YHF-1404/dc_adj/readme/png/S10519-10523960.png

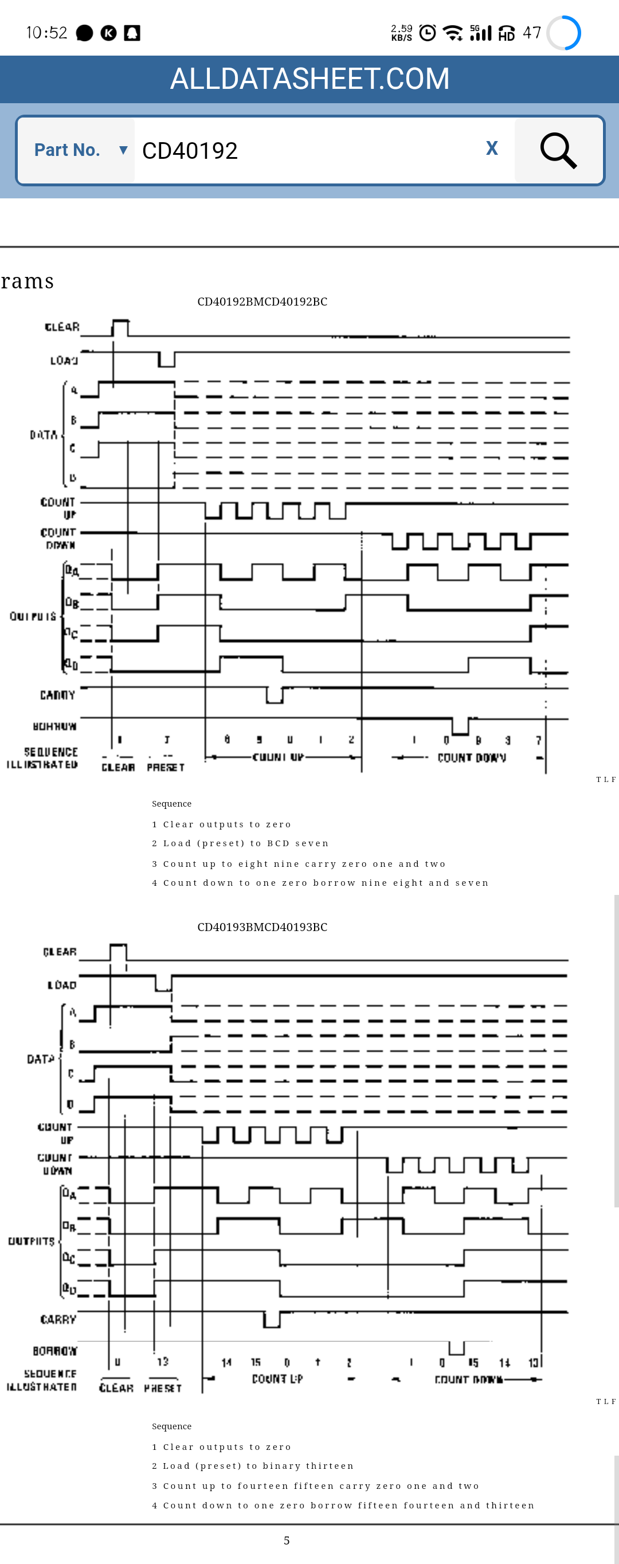
readme/png/S10519-10523960.png
