YHF-1404/dc_adj/readme/Schematic_dc_adj_2021-05-20.pdf

## 电源输出部分

## 输出电压测试端子

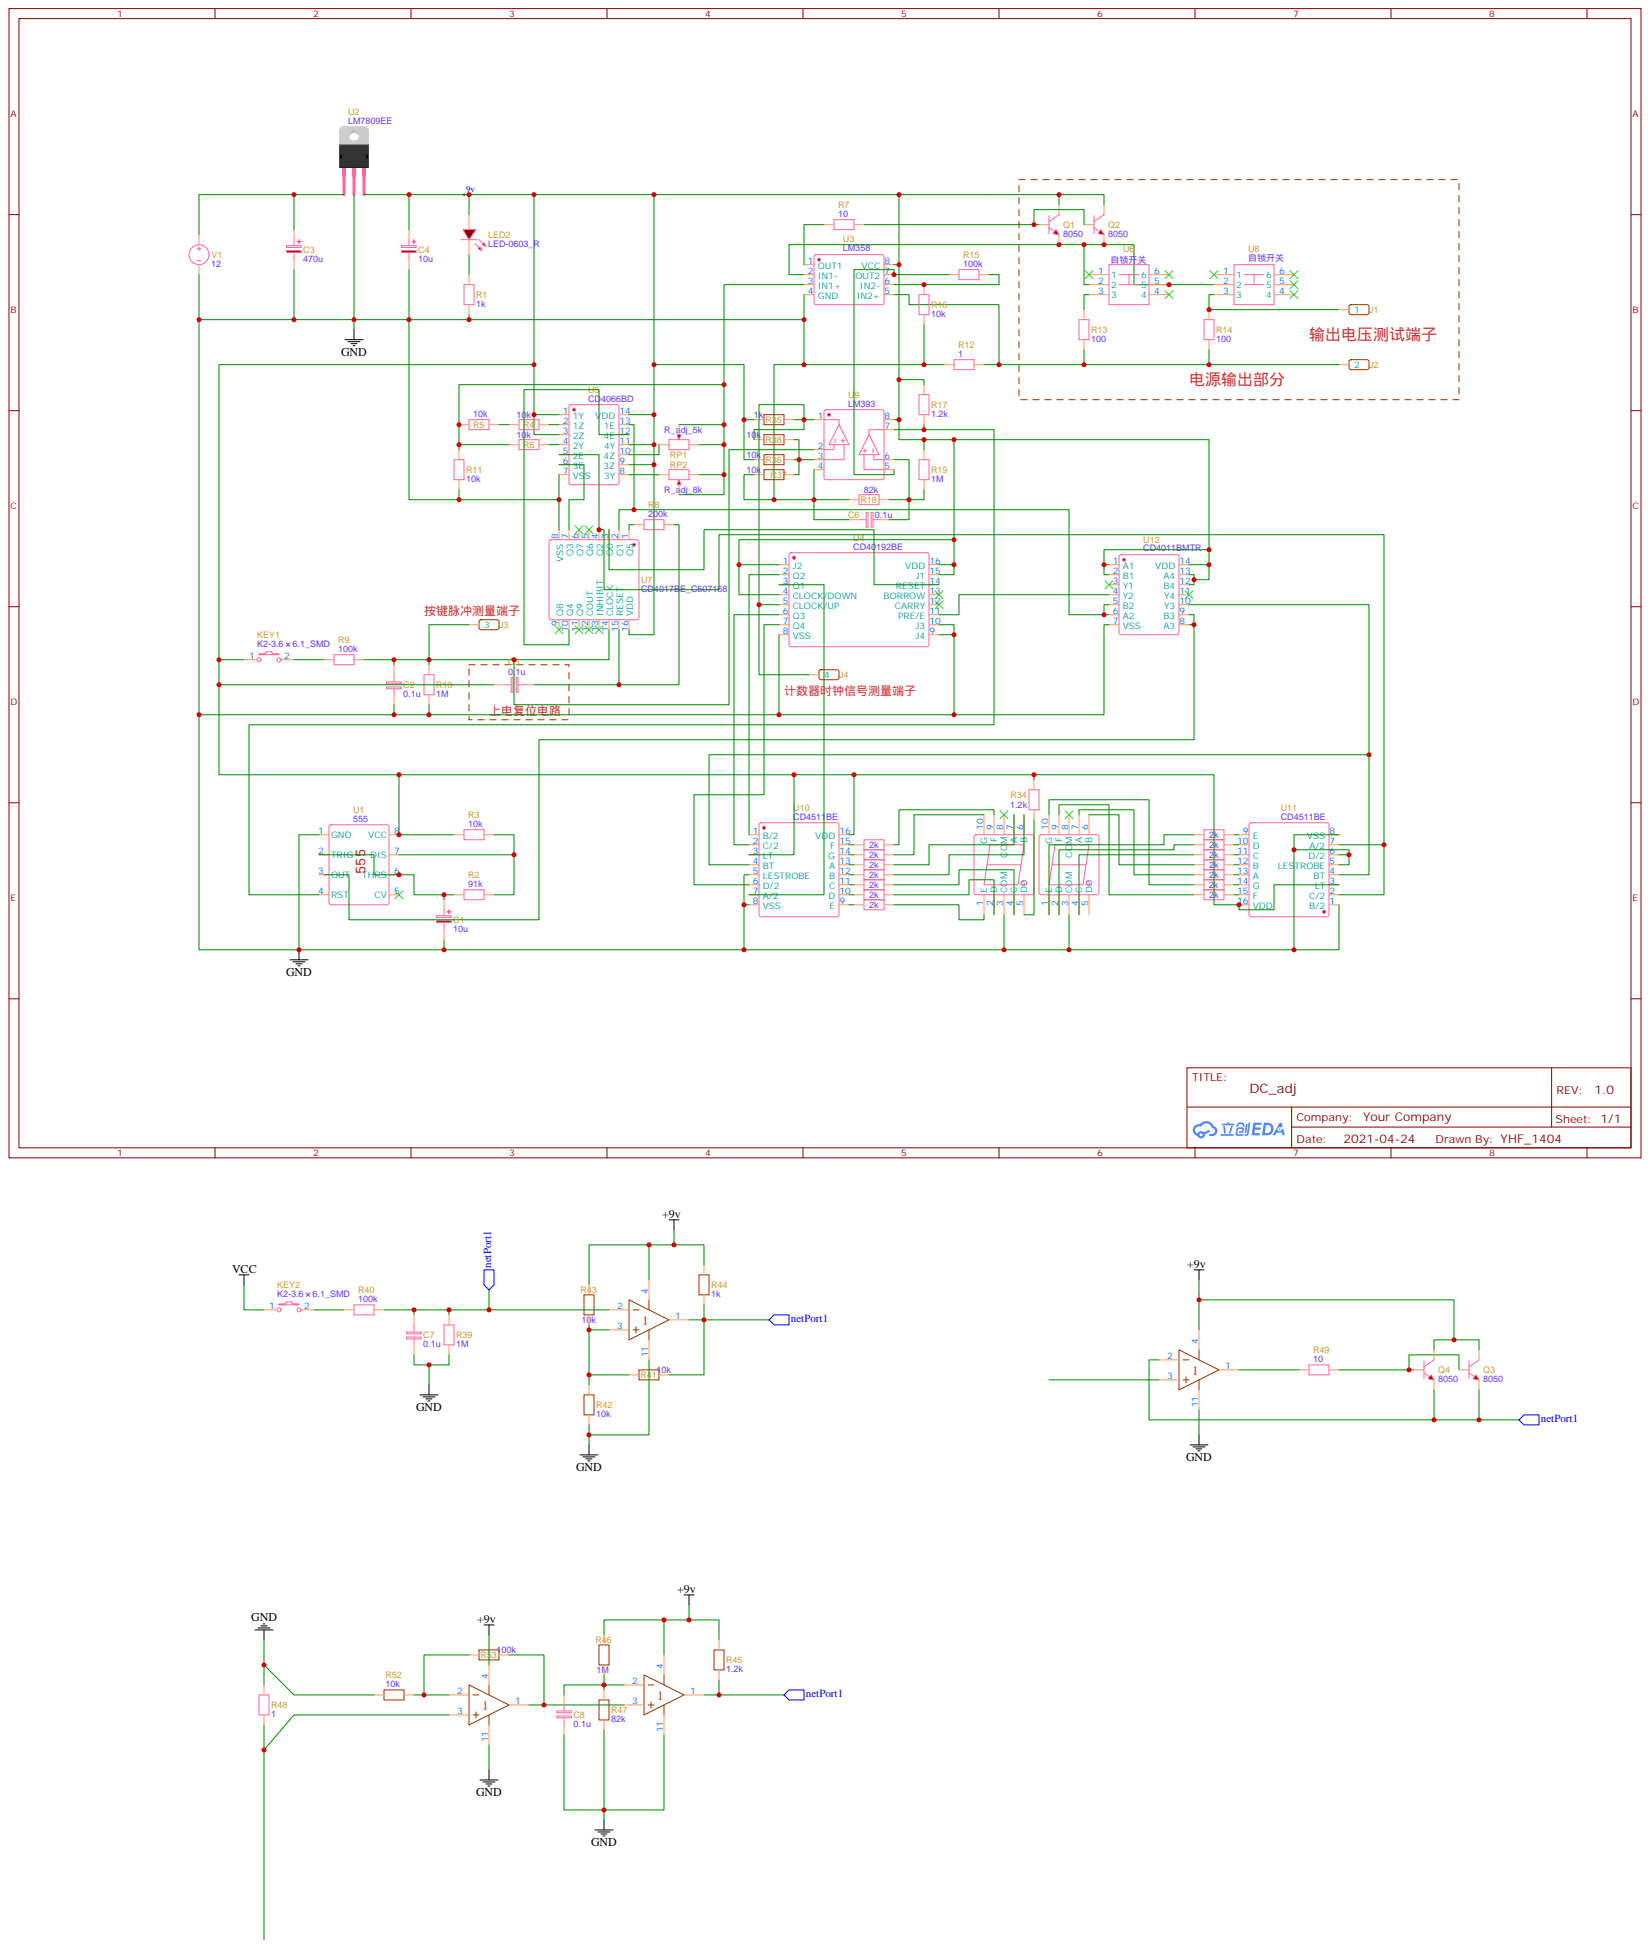
[picture p9: page 1]
