YHF-1404/dc_adj/readme/dc_adj.PDF

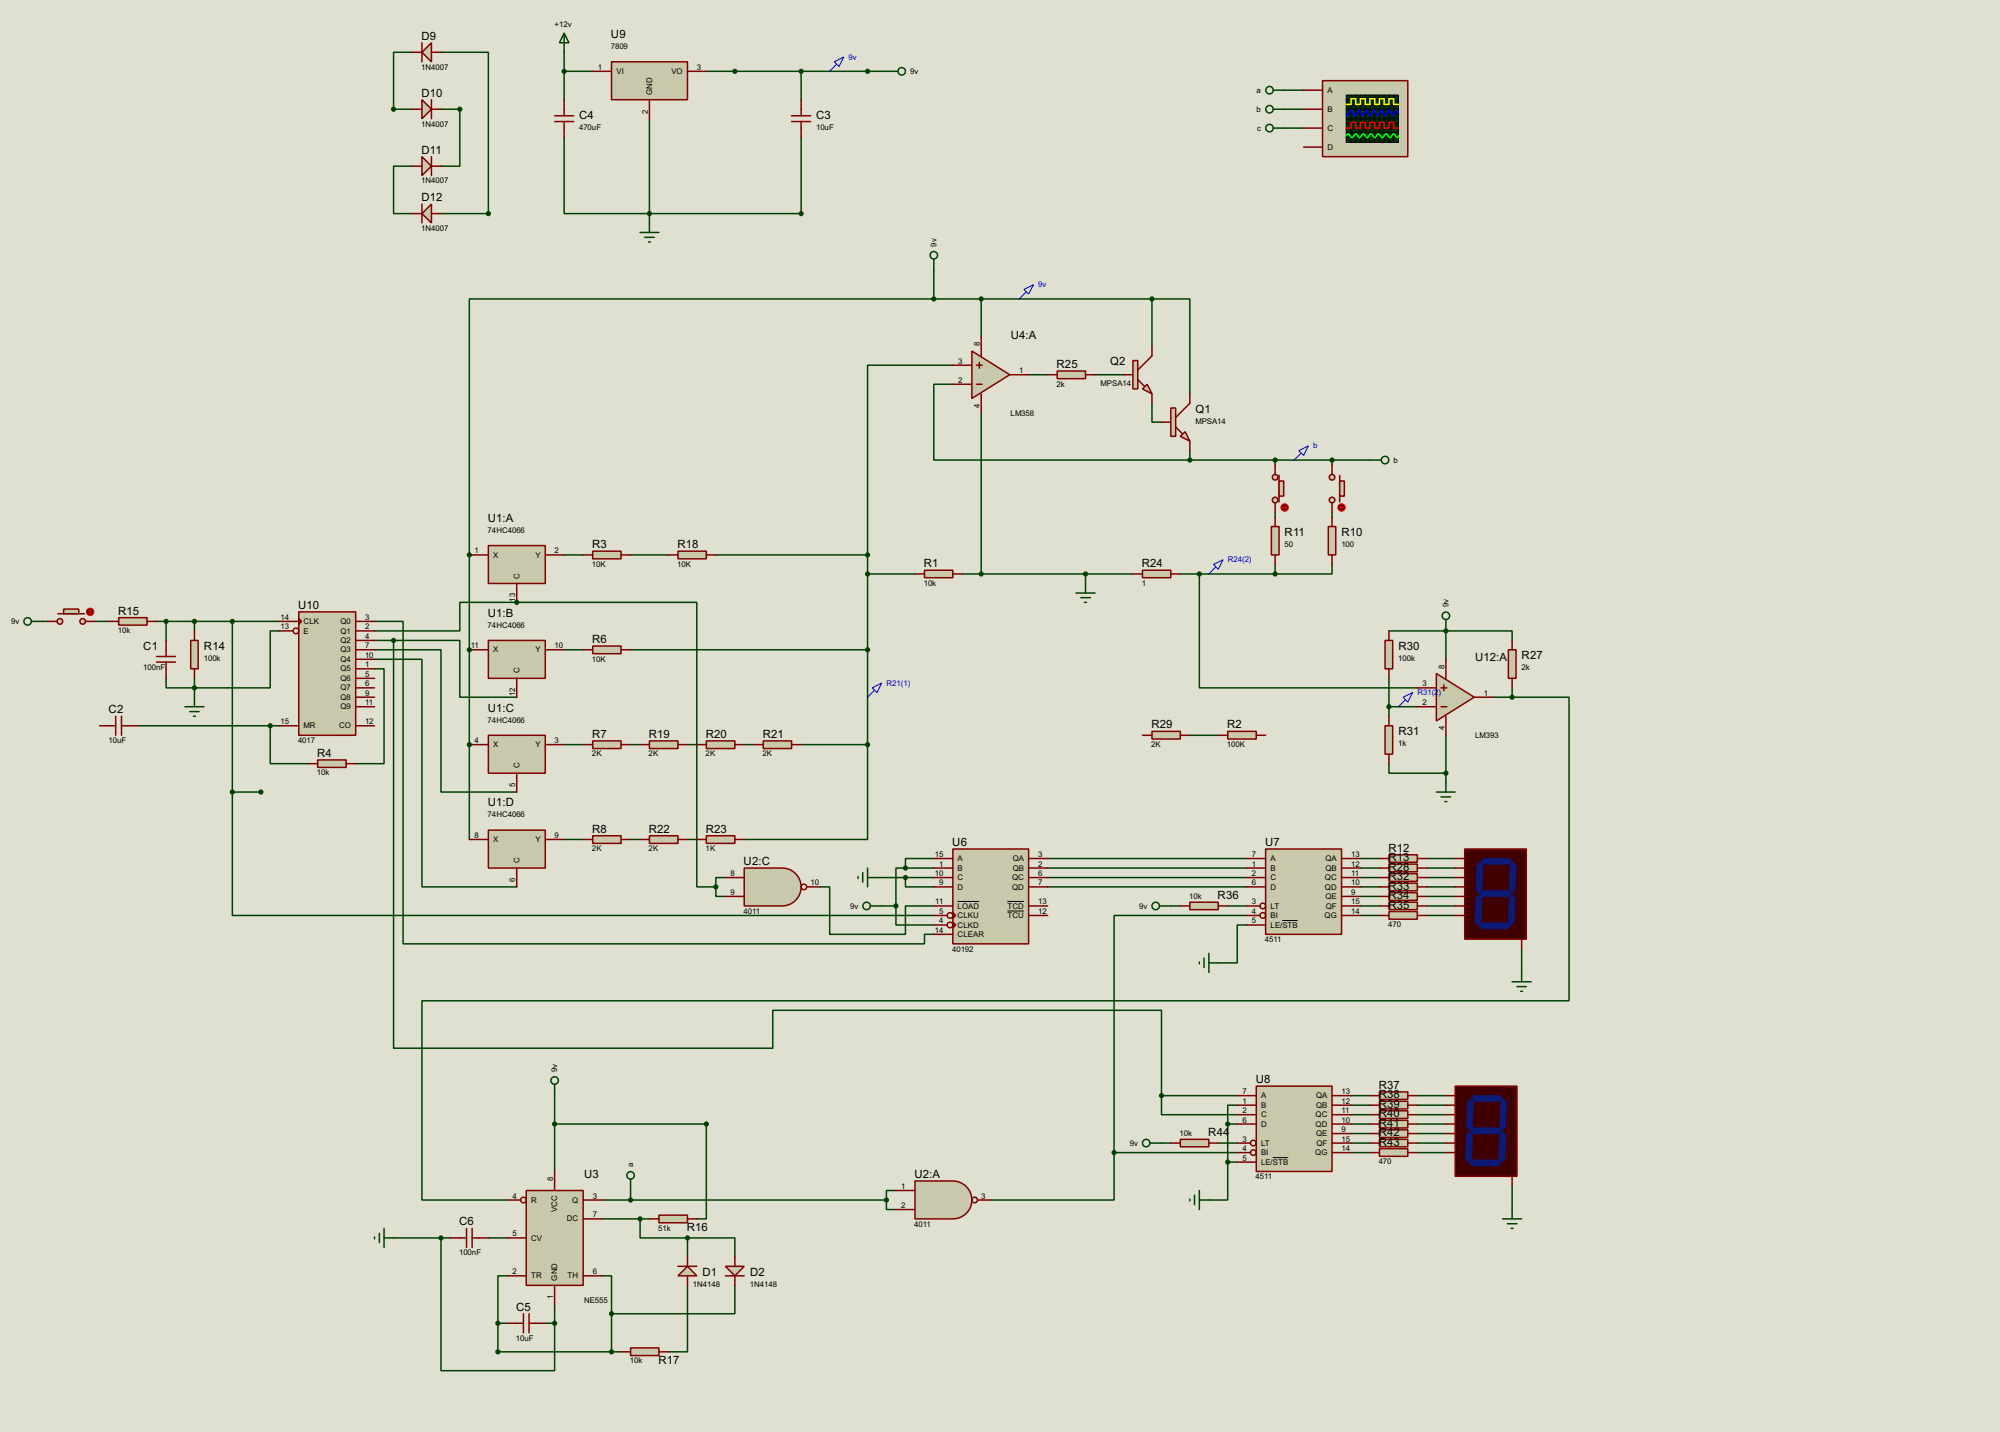
[picture p11: page 1]

4 Q3
7 Q4
10 Q5 1 Q6
