YHF-1404/dc_adj/(list of files, drawings)

Other design files:
proteus/dc_adj.pdsprj
